Dolfost/pedals/README.md

# Foot pedal box

**English** · [Українська](README.uk.md)

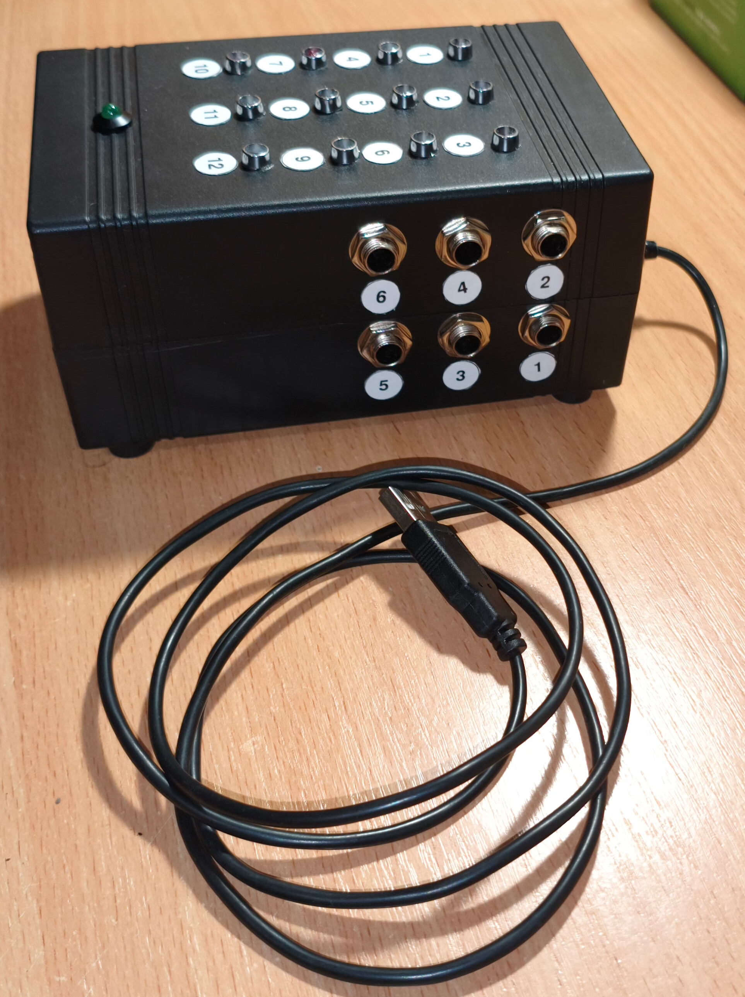
[picture p1: images/finish.jpg]
The finished box: twelve jacks, twelve LEDs, one USB cable


Twelve foot-pedal inputs for a PC, built around the controller board of a used Genius USB keyboard.
Each input is a 6.35 mm mono jack for a momentary tattoo pedal. 
Pressing a pedal lights that channel's LED and, through an optocoupler, presses one of F1-F12 on the keyboard matrix.
On the PC, keyd turns those keys into Ctrl+Alt+Shift+F1..F12 and REAPER scripts bound to them switch guitar amp tracks.
Whatever is left over is free for game binds.

## Story

The box exists to change guitar tones in REAPER without taking a hand off the guitar: one tone per pedal, up to twelve of them.
Ready-made USB foot switches (the PCsensor kind that the `footswitch` tool programs) offer one to three switches for real money: a triple one like the [FS323-P](https://prom.ua/ua/m-7539015935706131995-fs323-trojnaya-usb.html) is listed at 2,250 UAH on prom.ua, so twelve switches that way would be about 9,000.
Tattoo pedals are the opposite: sturdy metal momentary switches with a 6.35 mm mono plug on a stock cable, for a fraction of the price.
All they need is something to plug into.

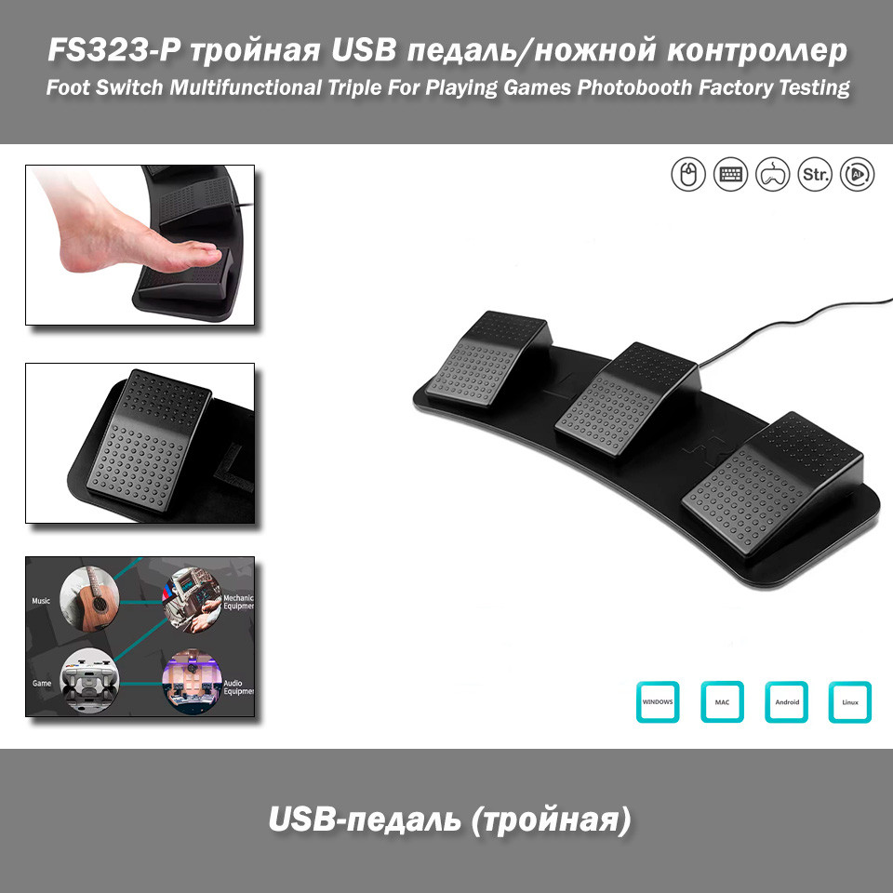
[picture p2: images/ready-made-fs323-p.jpg]
FS323-P: a ready-made triple USB foot pedal, 2,250 UAH


<p align="center">
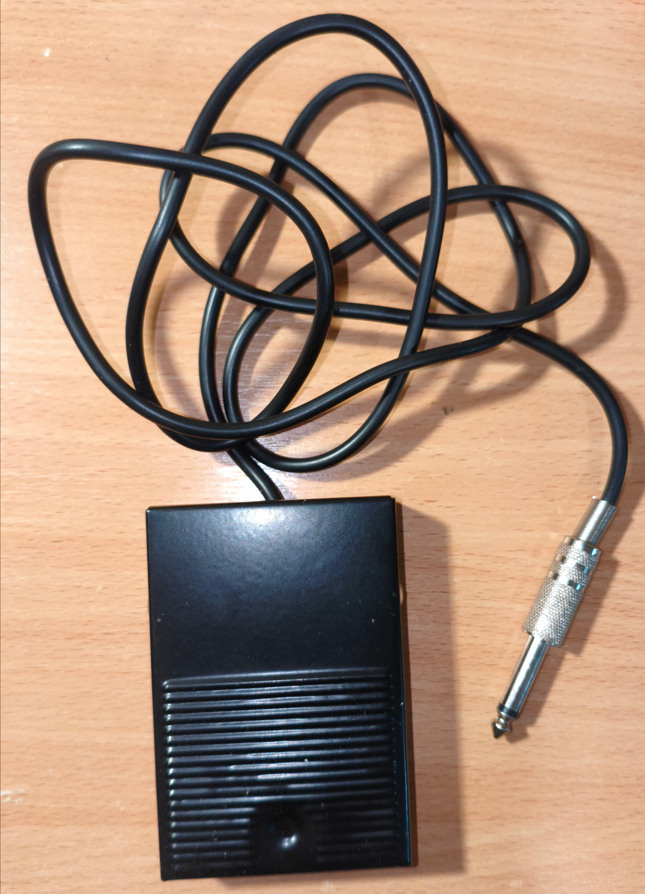
[picture p3: images/pedal_front.jpg]
A tattoo pedal: steel body, momentary switch, 6.35 mm mono plug on a stock cable

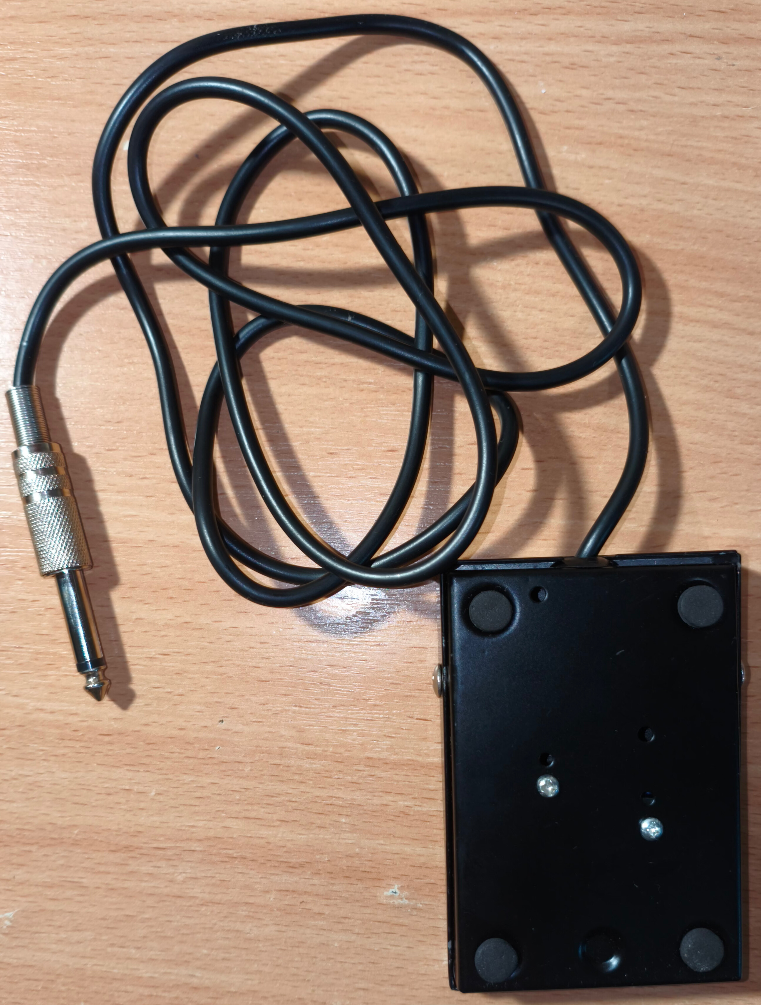
[picture p4: images/pedal_back.jpg]
The underside: four rubber feet and the switch screws

</p>

That something is the old Instructables recipe [A Foot Pedal for the Computer Keyboard](https://www.instructables.com/A-Foot-Pedal-for-the-Computer-Keyboard/): take a USB keyboard apart, keep the controller PCB, and close the matrix contacts of a key with a switch.
This build changes two things about it.

- **Nothing touches the matrix directly.** Each pedal closes a 5 V loop through a PC817 optocoupler, and the phototransistor presses the key.
The pedal cables are galvanically isolated from the controller, every channel gets a status LED in series for free, and since a phototransistor conducts one way only, pedals cannot ghost each other the way membrane contacts can.
- **The keys are F1-F12, and keyd rewrites them.** The box enumerates as an ordinary keyboard, so without a remap every pedal would collide with the real keyboard.
A per-device keyd config turns each F-key into a Ctrl+Alt+Shift chord that nothing else types.

The first case layout put all twelve jacks on one long side with the LEDs next to them.
The final one splits the jacks six per side, one row per case shell, and moves the LEDs to the top where they are visible from above.
The first case considered (Sanhe 11-4, 100 x 68 x 50 mm) turned out too small for twelve jacks; the D150B at 148 x 92 x 68 mm with removable end panels is what got built.

| When | What |
|---|---|
| 2026-10-11 | USB foot pedals considered; `footswitch` tooling added to the NixOS config |
| 2026-10-13 | parts list priced and ordered ([PARTS.md](PARTS.md)) |
| 2026-10-14 | matrix pins measured, schematic drawn, generator script written |
| 2026-10-16 .. 17 | donor keyboard stripped, controller connector extended onto perfboard |
| 2026-10-18 | opto board built and bench-tested against the controller; drill templates drawn in FreeCAD |
| 2026-10-23 | case drilled, everything assembled, labels on; keyd and REAPER configs committed to dotfiles |

## How it works

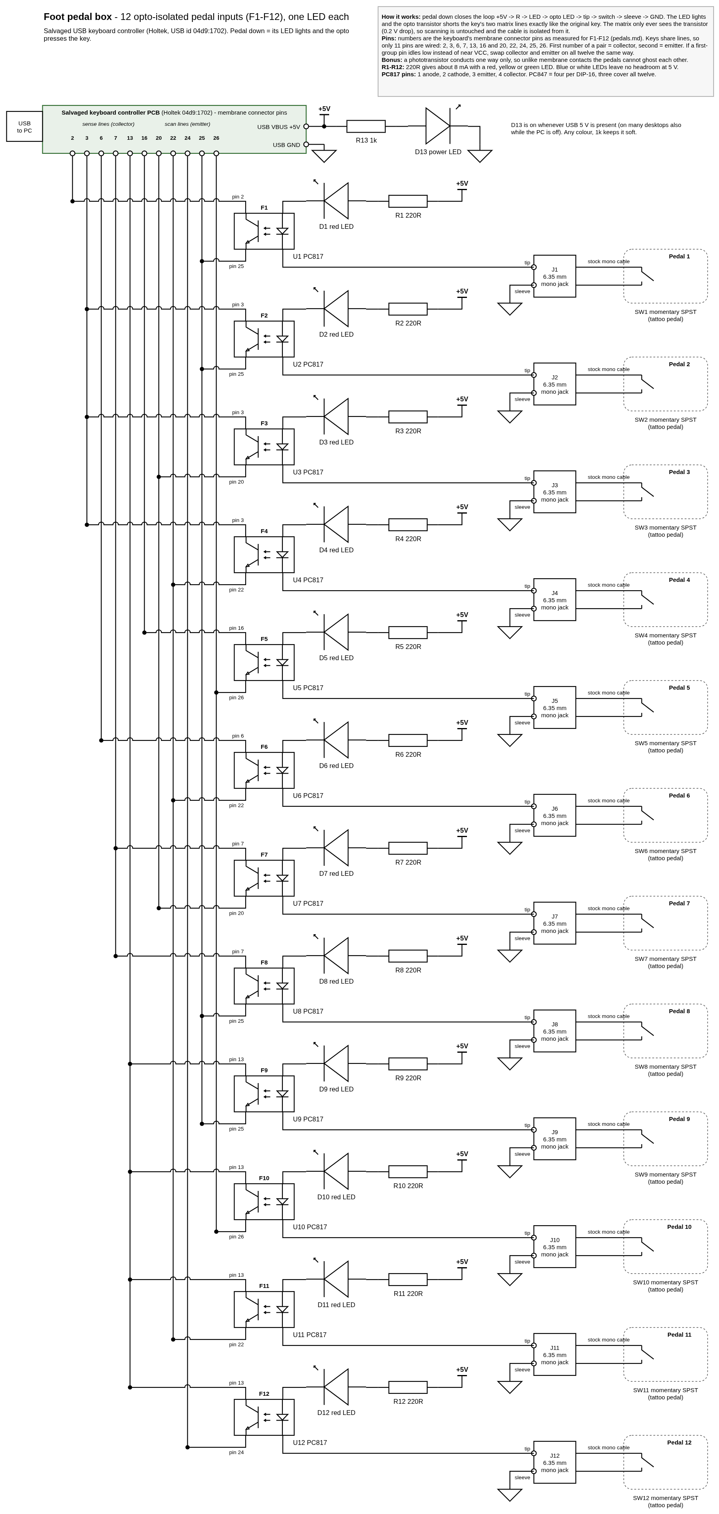
[picture p5: pedal-box-schematic.png]
Schematic


Editable source: [pedal-box-schematic.drawio](pedal-box-schematic.drawio).
The file is generated by [gen-schematic.pl](gen-schematic.pl), see [Regenerating](#regenerating).

Pedal down closes a 5 V loop: `+5V -> 220R -> LED -> PC817 input -> jack tip -> pedal switch -> jack sleeve -> GND`.
The LED lights, and the PC817 phototransistor shorts the key's two matrix lines exactly like the original key did.
The matrix only ever sees the transistor (about 0.2 V drop), so scanning is untouched, and the pedal cable is galvanically isolated from it.

Never put an LED in series with the matrix contact itself: its forward voltage eats the logic margin and the scan pulses are microamps anyway.

The power LED (D13) sits straight across USB 5 V through 1k and is on whenever the port is powered, which on many desktops includes soft-off.

### Measured connector pins

Pins of the keyboard's membrane connector that produce each key, measured by shorting pairs with a wire while watching `sudo keyd monitor`.

| Key | pin a (collector) | pin b (emitter) |
|-----|---|---|
| F1  | 2 | 25 |
| F2  | 3 | 25 |
| F3  | 3 | 20 |
| F4  | 3 | 22 |
| F5  | 16 | 26 |
| F6  | 6 | 22 |
| F7  | 7 | 20 |
| F8  | 7 | 25 |
| F9  | 13 | 25 |
| F10 | 13 | 26 |
| F11 | 13 | 22 |
| F12 | 13 | 24 |

Keys share lines, so only 11 pins are wired: 2, 3, 6, 7, 13, 16 (sense lines) and 20, 22, 24, 25, 26 (scan lines). 
Eleven wires run from the controller to the opto board, not 24.

### Circuit notes

- Sense vs scan: with the board powered, the pad of a pair that idles near VCC is the sense line (collector), the pulsed one is the scan line (emitter).
The table assumes the first number is sense.
If a sense pin idles low instead, swap collector and emitter on all twelve optos the same way.
Wrong polarity only means no key event, nothing breaks.
- Resistors: 220R gives about 8 mA through a red, yellow or green LED plus the opto input.
Blue or white LEDs leave no headroom at 5 V.
For the power LED alone, 330R is bright and 1k is dim with red, yellow or green.
- LED polarity: anode toward +5V (through the resistor), cathode toward the opto anode.
PC817 pins: 1 anode, 2 cathode, 3 emitter, 4 collector.
- Keep the controller PCB intact and its USB cable; tap VBUS and GND where the cable lands on the PCB.

## Build log

### Donor controller

<p>
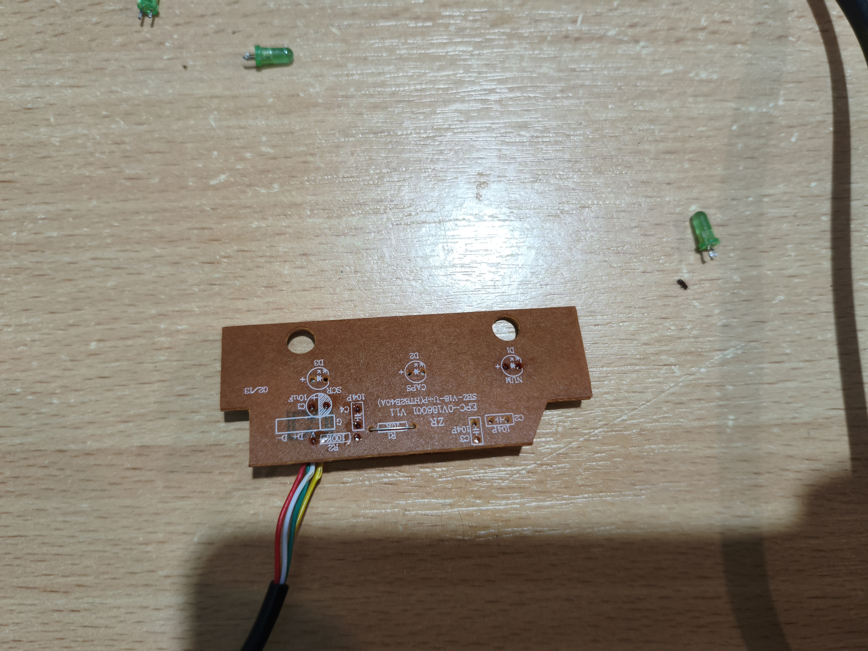
[picture p6: images/kb_board_front.jpg]
Controller PCB, component side

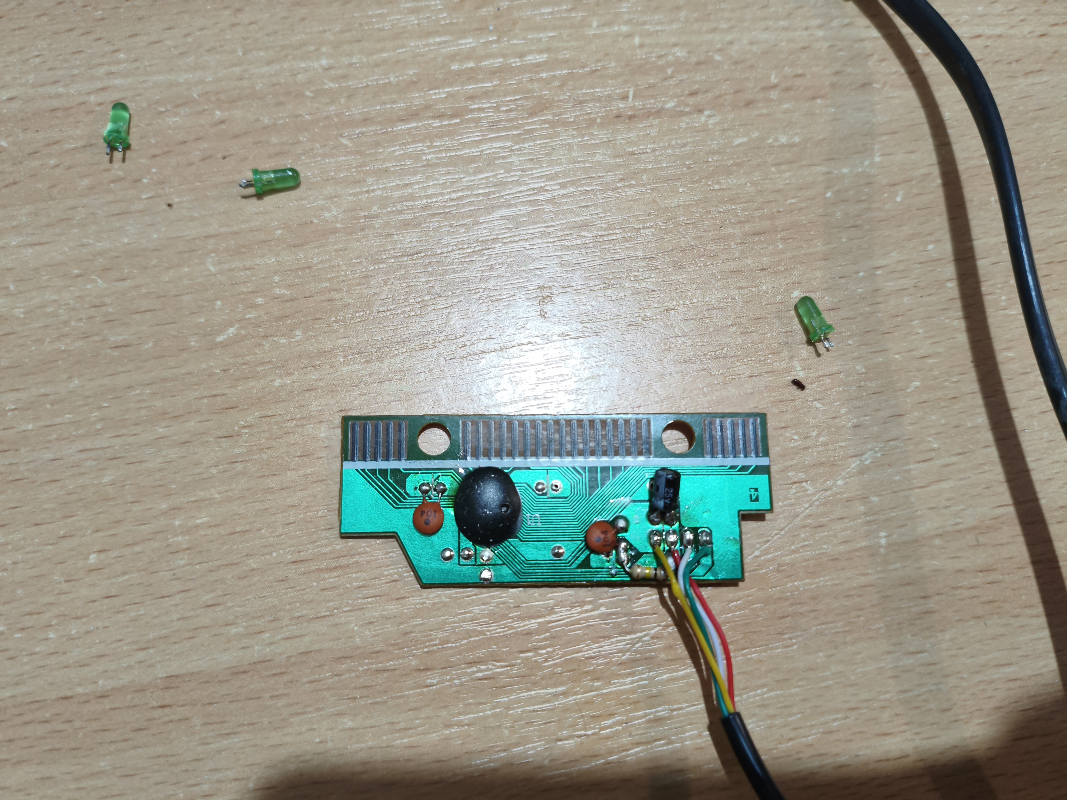
[picture p7: images/kb_board_back.jpg]
Controller PCB, contact side

</p>

The controller of a used Genius USB keyboard (Holtek, USB id 04d9:1702, PCB marked EPC-OV186001 V1.1): a chip-on-board blob, a handful of passives, the USB cable, and a row of 26 contact fingers along one edge where the membrane used to plug in. 
The three green LEDs next to it are the Num, Caps and Scroll indicators, desoldered.

### Extending the connector

<p>
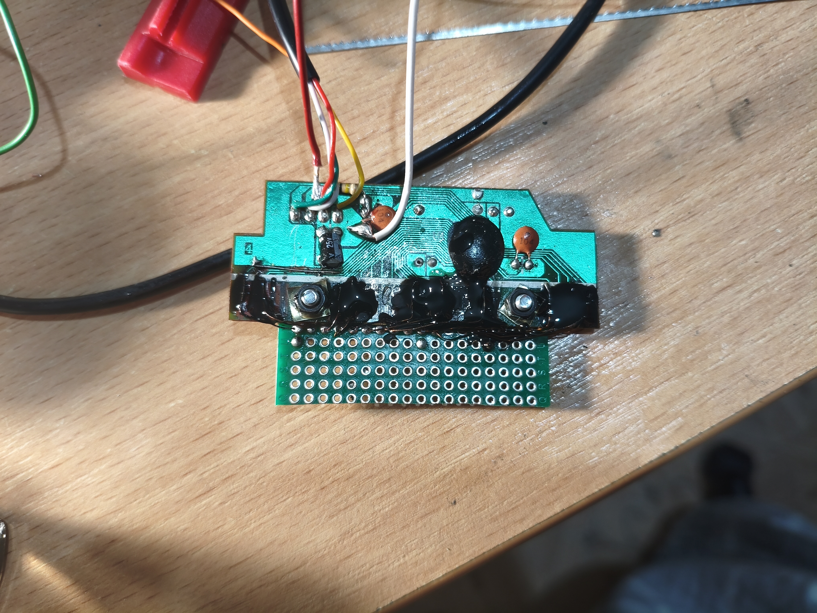
[picture p8: images/kb_board_extended_with_prototype_board.jpg]
Perfboard strip glued along the connector edge

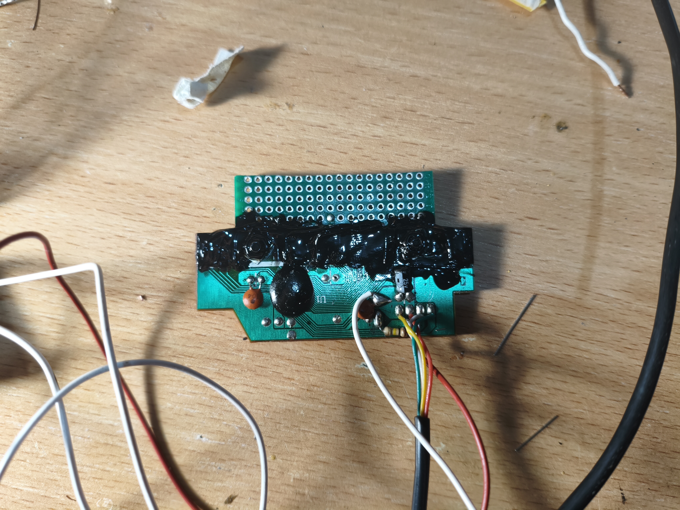
[picture p9: images/kb_board_extended_with_prototype_board_2.jpg]
The same from the other side

</p>

Membrane fingers cannot take hook-up wire, so a strip of perfboard was glued along the connector edge, each pad was run to a perfboard pad with thin enamel wire, and the joints were sealed under a coat of black nail polish.
The eleven matrix lines and USB power now come off the perfboard pads instead.

### Opto board

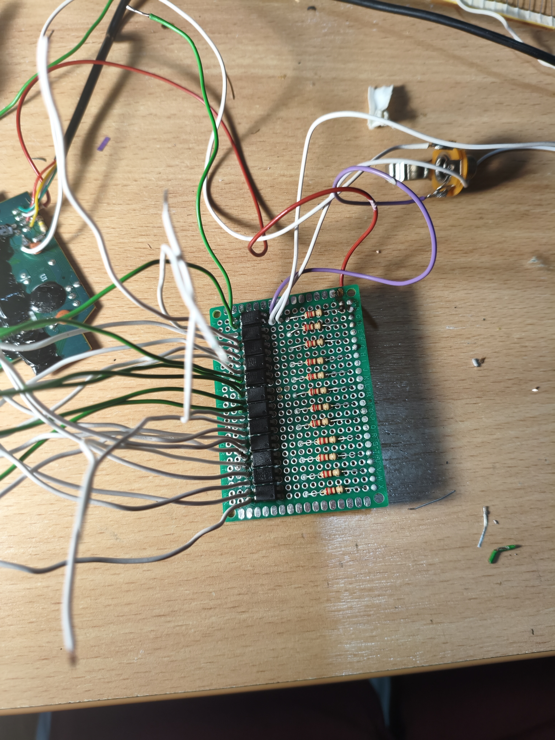
[picture p10: images/optotrons_on_pcb.jpg]
Twelve PC817 and twelve resistors on a 50 x 70 mm perfboard


Twelve PC817 in a column and twelve 220R resistors next to them on a 50 x 70 mm perfboard.
The green wires are the eleven matrix lines from the controller; the pedal, LED and ground wires go out the other side.
The jack in the corner is the first one wired up for testing.

### Bench test

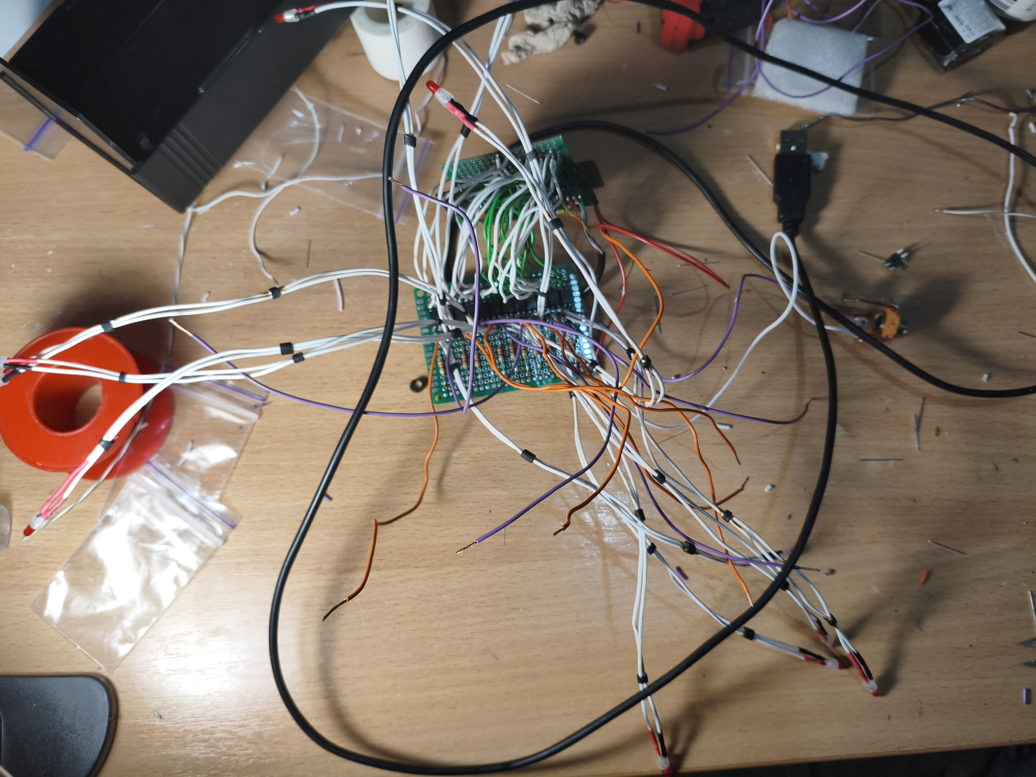
[picture p11: images/optotrons_paired_with_keyboard_board.jpg]
Controller and opto board wired together on the bench


Everything wired together on the bench before any hole was drilled: the controller, the opto board, twelve LEDs on heat-shrunk leads, one jack and the USB cable, and each channel checked before going further.

### Case design

The case is drawn in FreeCAD ([connectors.FCStd](connectors.FCStd)): one sketch per panel of the D150B, plus two TechDraw pages that were printed at 1:1 and used as drill templates. 
The sketches, as drawn (dashed lines are construction geometry):

| | |
|---|---|
| top | side |
| bottom | front |
| back | first side layout |
| label study | |

Where things go:

- **Side panels** (left and right): six jacks each in two rows of three at 21 mm pitch.
The rows sit 13 mm above and 6.5 mm below the seam, so each row is in its own case shell and the shells still come apart.
All jacks are on one half of the panel; the boards live in the other half.
- **Top**: twelve LED holders on a 3 x 4 grid at 20 x 25 mm between the case's decorative grooves, and the power LED off to one side.
- **Bottom**: four M3 holes on a 45 x 65 mm pattern for the opto board, with nuts stacked as spacers.
- **Front end panel**: two M3 holes 39.5 mm apart, matching the two mounting holes the controller PCB already had.
- **Back end panel**: one 12.5 mm hole for the PG7 gland the USB cable passes through.

The TechDraw pages, [lrt.pdf](lrt.pdf) (left, right, top) and
[fbb.pdf](fbb.pdf) (front, back, bottom):

<p>
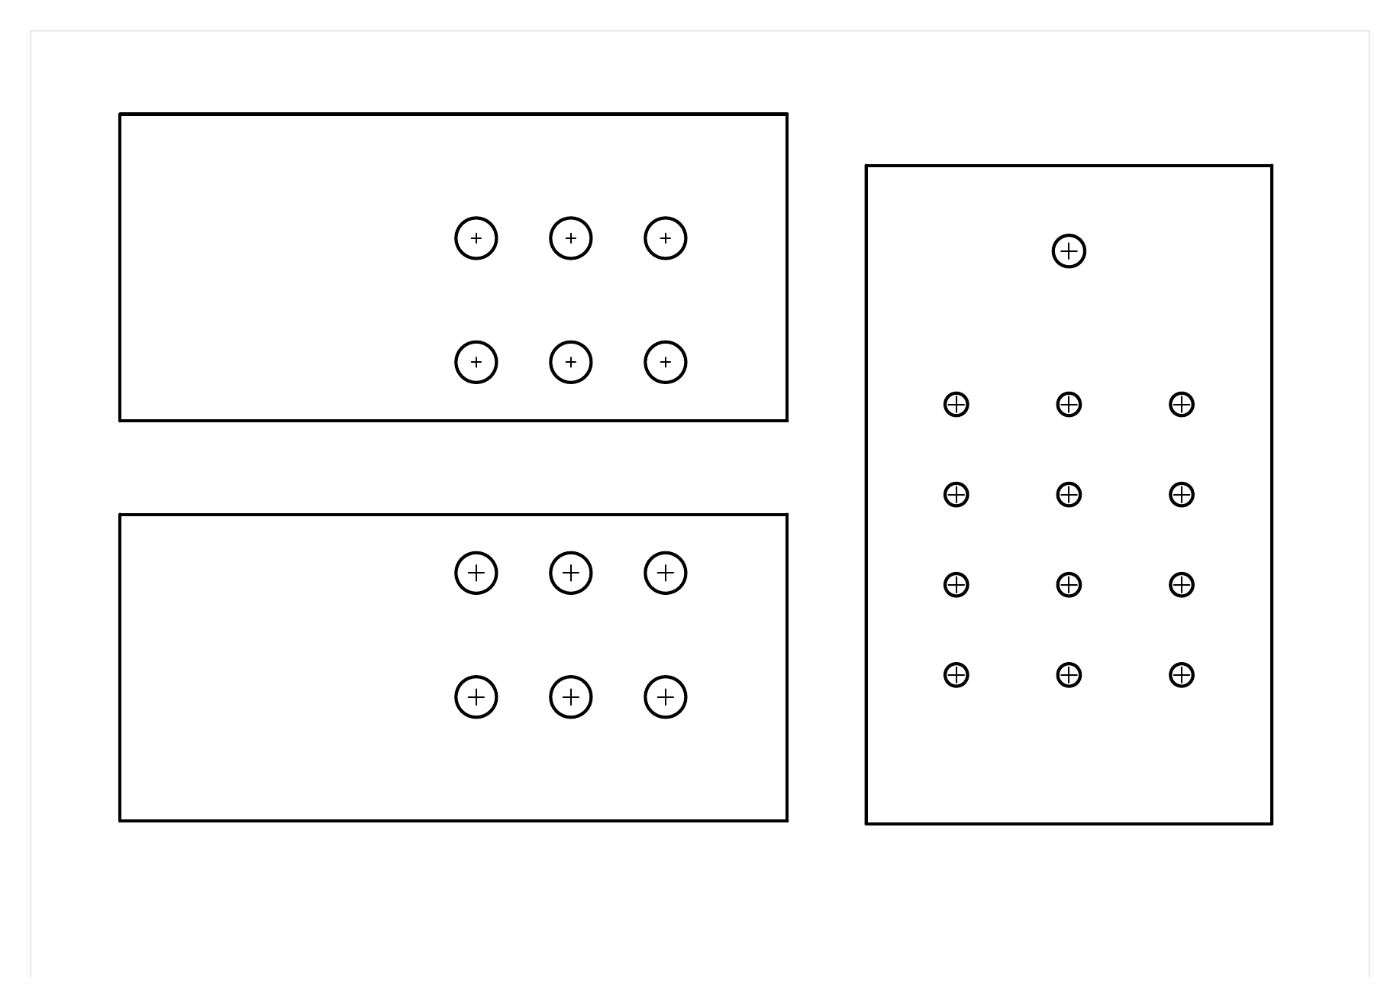
[picture p12: images/sketches/lrt.png]
Drill template: left, right and top panels

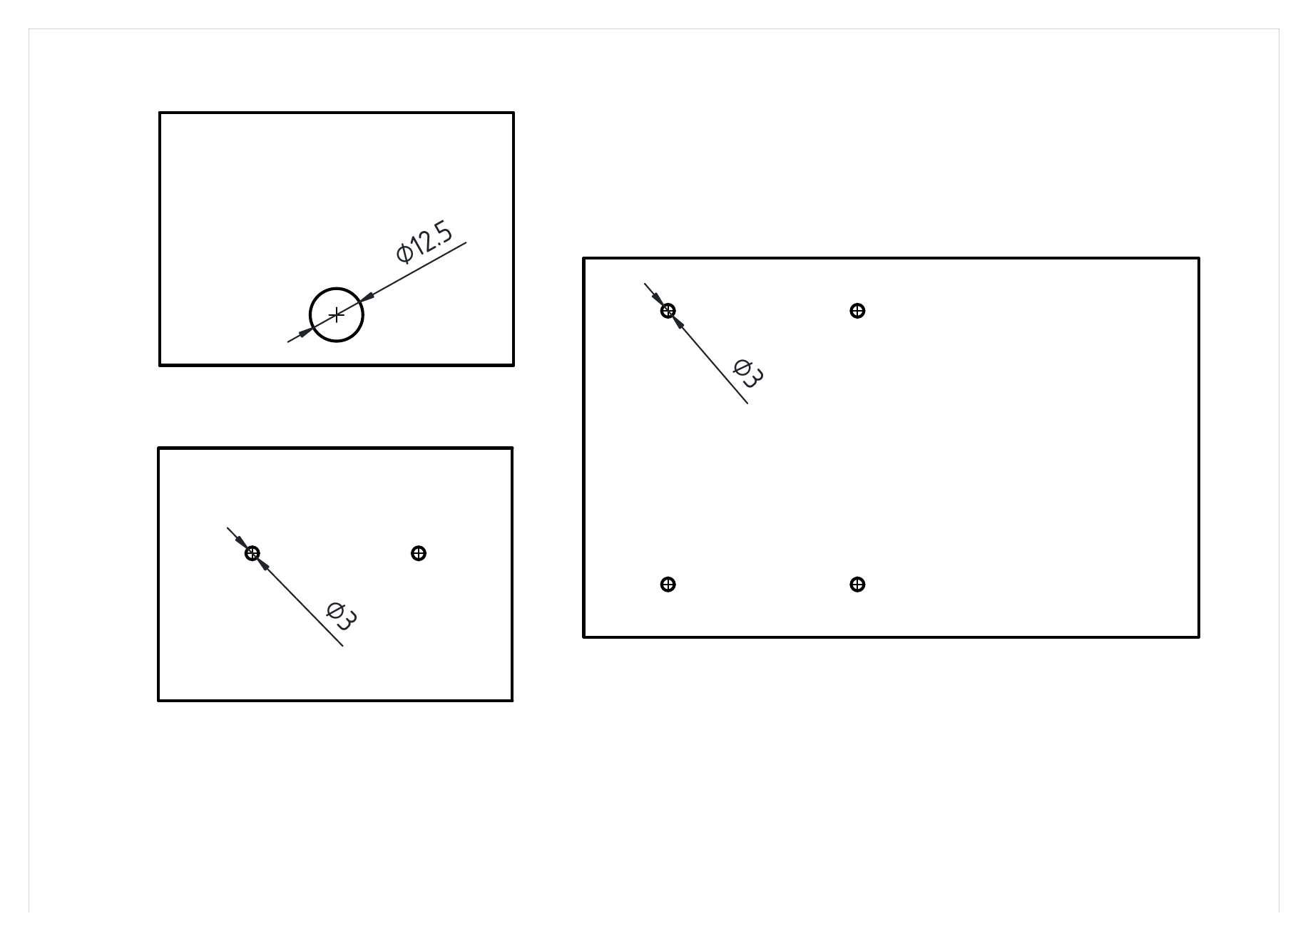
[picture p13: images/sketches/fbb.png]
Drill template: front, back and bottom panels

</p>

Drill sizes used, and what the parts actually measure:

| Part | Hole drawn | Part measured |
|---|---|---|
| 6.35 mm jack GT1-2025 | 9 mm | 8 mm bush, 14 mm nut |
| 3 mm LED holder PLH-3 | 5 mm | 5.5 mm body, 8 mm bezel |
| power LED holder | 7 mm | 8 mm body, 9 mm bezel |
| PG7 gland | 12.5 mm | |
| M3 screws | 3 mm | |

### Drilling

<p>
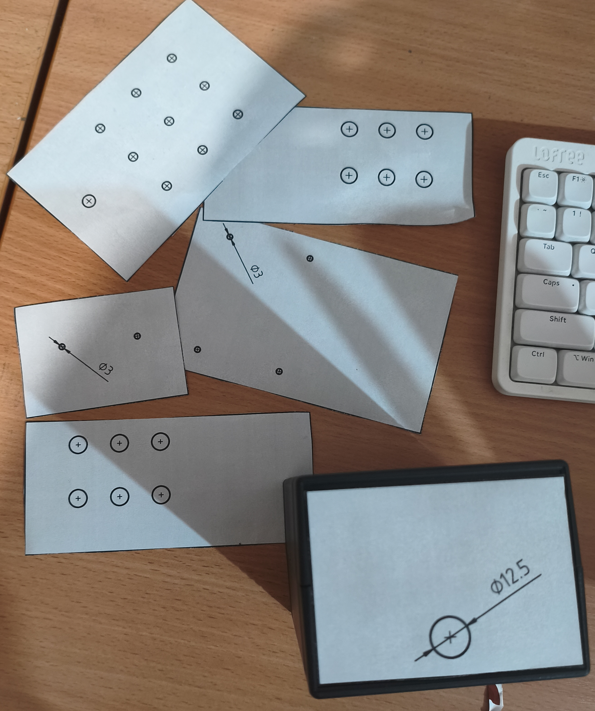
[picture p14: images/hole_templates.jpg]
Printed templates cut out and laid on the panels

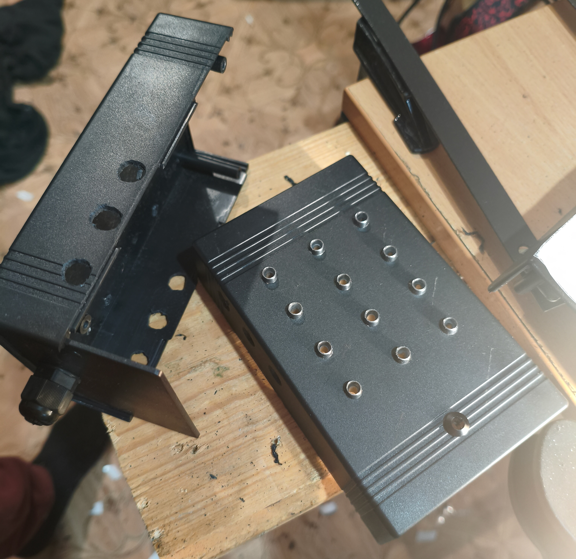
[picture p15: images/case_cut_process.jpg]
Top and side panels drilled, gland fitted

</p>

The pages were printed at 100 %, cut out, taped to the panels, and the holes drilled straight through the paper.
The large holes for the jacks, the power LED and the gland were drilled undersize and reamed out to size with scissors.
The gland went into its end panel first.

### Assembly

<p>
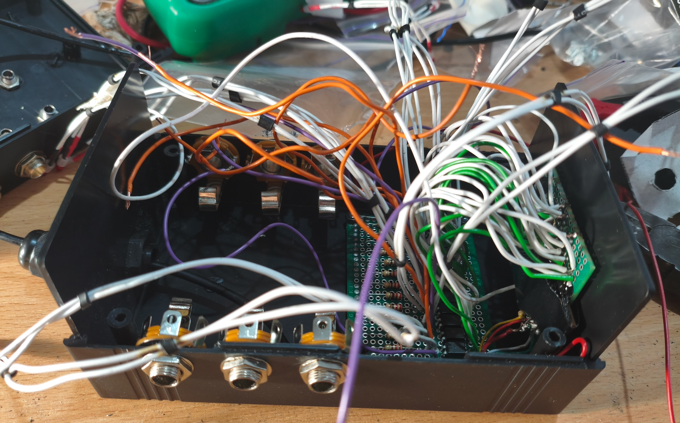
[picture p16: images/case_compontents_inside.jpg]
Jacks mounted, boards going in

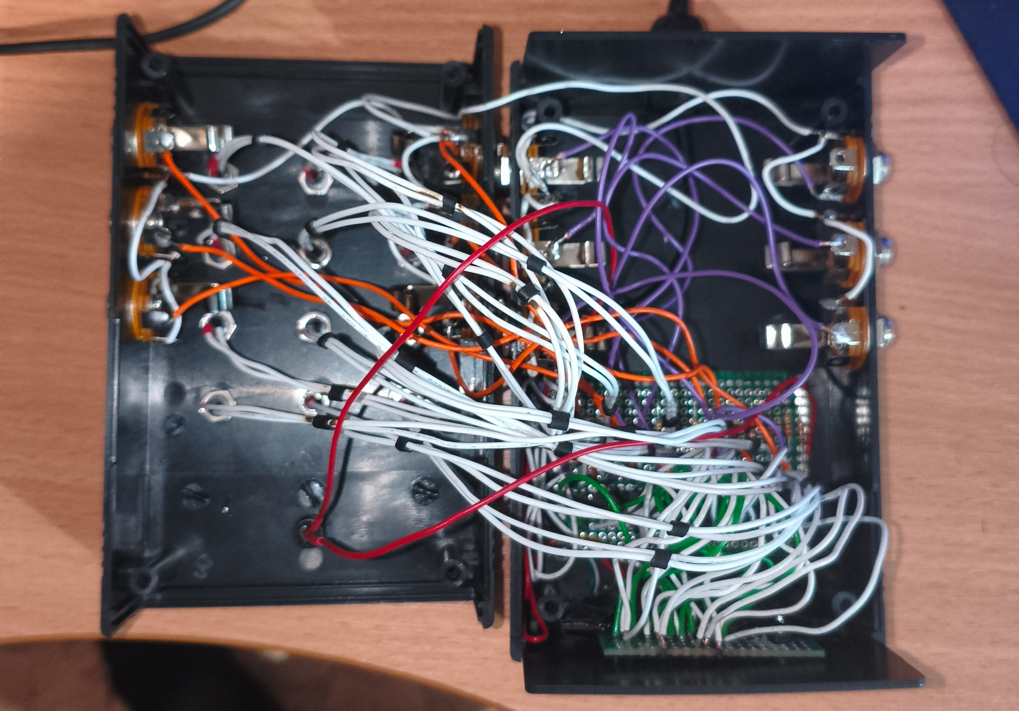
[picture p17: images/case_compontents_inside_leds_in.jpg]
Both shells open, LEDs in their holders

</p>
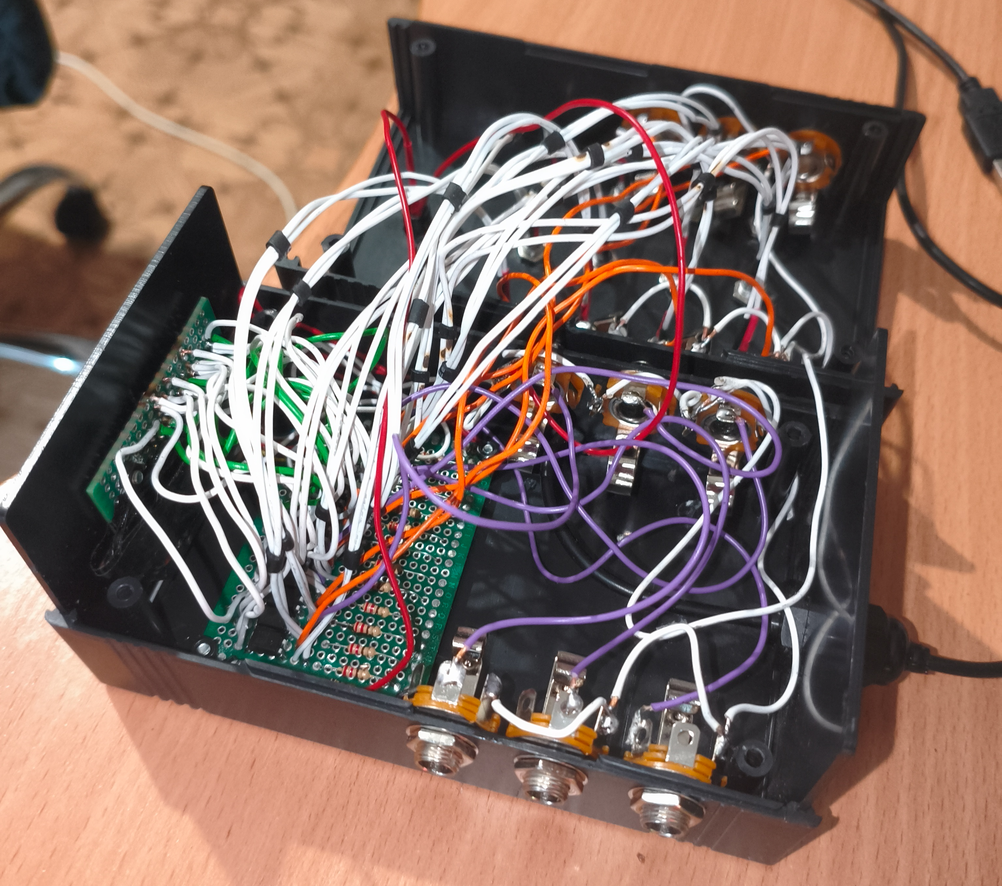
[picture p18: images/case_compontents_inside_leds_in_other_angle.jpg]
Controller on the end panel, opto board on the bottom


Jacks in both shells, the controller with its perfboard extension screwed to the front end panel, the opto board on the bottom, LEDs in their holders in the top shell.
Wire ends at the jacks and LEDs are heat-shrunk.

### Labels

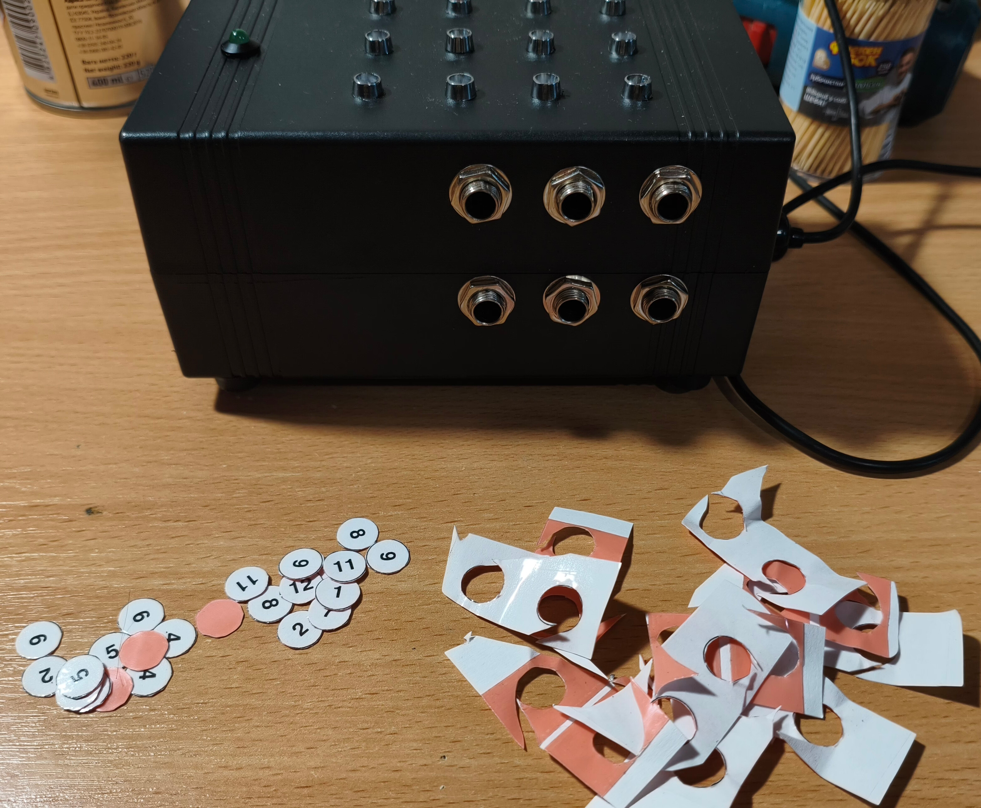
[picture p19: images/case_labels.jpg]
The closed box and a pile of cut-out number labels


[labels-1-12.pdf](labels-1-12.pdf) is a sheet of two sets of numbered discs (print at 100 %, no page scaling; there is a 50 mm reference bar).
Printed on plain paper, laminated with Scotch tape on the front and double-sided tape on the back, then cut out:

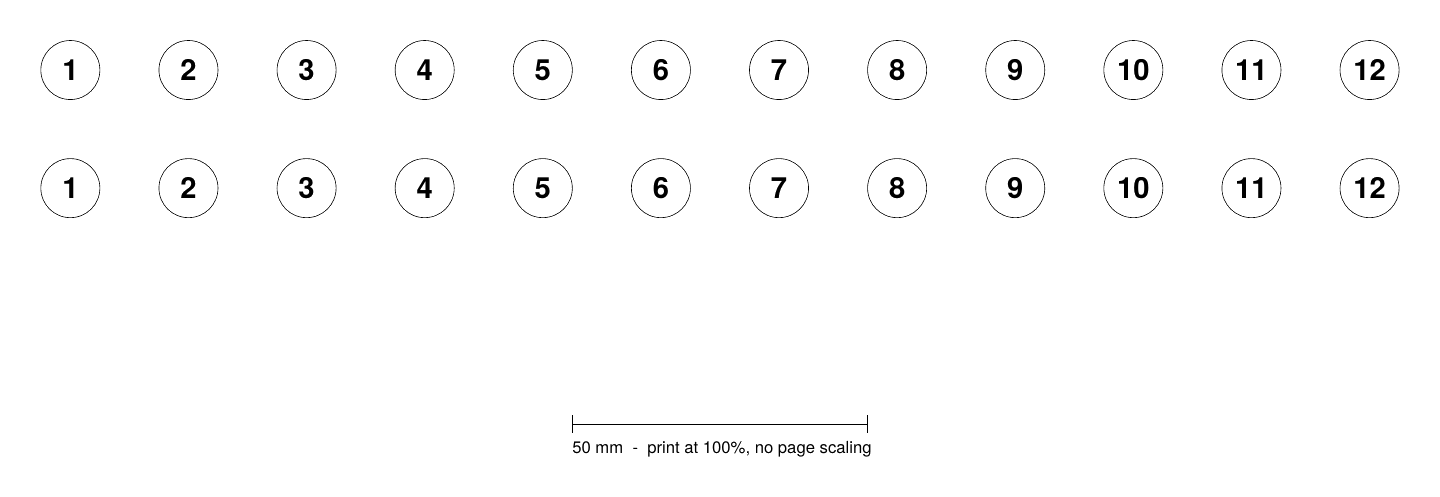
[picture p20: images/sketches/labels-1-12.png]
The label sheet


### Result

<p align="center">
Finished box
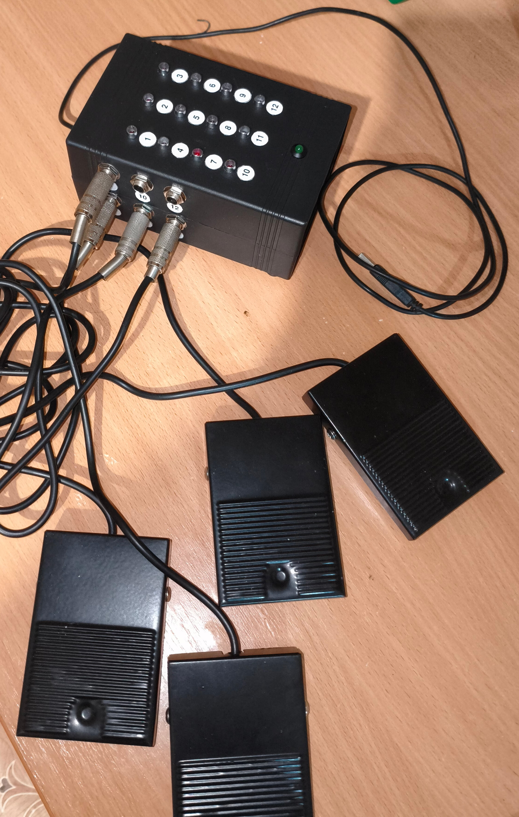
[picture p21: images/finish_with_cables.jpg]
The box with four pedals plugged in

</p>

Jacks 1-6 on one side, 7-12 on the other, LED for each on top, a green power LED in the corner, one USB cable out the back.
Four pedals so far; the other eight jacks wait for more.

## Software

### keyd

The box enumerates as the original keyboard (Holtek, USB id 04d9:1702).
On NixOS, `nix/modules/system/pedal/default.nix` in the dotfiles gives it its own keyd config, which is what the host actually runs:

```nix
services.keyd.keyboards.pedal = {
  ids = [ "04d9:1702" ];
  settings = {
    # A held macro key starts repeating after this; at ~25 days it never does.
    global.macro_timeout = 2147483647;
    main = {
      f1 = "macro(C-A-S-f1)";
      f2 = "macro(C-A-S-f2)";
      # ...
      f12 = "macro(C-A-S-f12)";
    };
  };
};
```

[keyd/pedal.conf](keyd/pedal.conf) is the same thing as a plain keyd file for a non-Nix machine.
An explicit id beats the `*` default config, so the board gets only this file.
Two things are going on in it:

- **A macro instead of a remap.** The controller holds the key down for as long as the foot is on the pedal, and the compositor turns that into auto-repeat, so a REAPER action bound to a plain key would fire over and over.
`macro(...)` presses and releases the chord once when the pedal goes down and does nothing more until it comes up; the huge `macro_timeout` stops the macro itself from repeating.
- **Ctrl+Alt+Shift+F1..F12, not F13..F24.** F13-F24 look like the obvious free keys, but they do not survive the trip: the default xkb map turns FK13..FK23 into XF86Tools/Launch/Touchpad keysyms, and REAPER's SWELL only translates F1..F12 to begin with.
A three-modifier chord collides with nothing a keyboard types, and Shift keeps Ctrl+Alt+Fn from being read as a VT switch.

The same module installs `footswitch`, the programmer for PCsensor-style USB pedals, which this box does not need.

### REAPER

`reaper/Scripts/amp-switch/` in the dotfiles holds `amp_1.lua` through `amp_12.lua` and `amp_cycle.lua`.
A copy is kept here under [reaper/amp-switch/](reaper/amp-switch/) for the record; REAPER loads the ones in the dotfiles.
Each `amp_N.lua` arms exactly the N-th track whose name starts with `GT_` (record arm plus input monitoring) and unarms the other `GT_` tracks, so one pedal is one amp chain.
`amp_cycle.lua` alternates between two of them from a single pedal.
The home-manager guitar module links the directory into REAPER's resource path so the scripts show up under ReaScript: Load; the key bindings themselves are assigned once per machine in the Actions list, because REAPER rewrites `reaper-kb.ini` on exit and keeping it in the repo would fight it.

### Probing notes

Learned while finding the matrix pins:

- keyd classifies a device as a keyboard only if it has the letter keys or a media key.
The board's "System Control" USB interface (power, sleep, wake) has neither, so keyd ignores it and logind reads it directly.
Shorting the wrong trace can shut the PC down.
For a probing session hold an inhibitor first:
  `systemd-inhibit --what=handle-power-key:handle-suspend-key:handle-hibernate-key:handle-reboot-key --who=pedal sleep 7200`
- `keyd monitor` cannot see devices the daemon has grabbed; it shows the virtual keyboard's output instead, which is fine for finding keys.

## Parts

Prices in UAH as listed by the shops on 2026-10-13.
"Bought" includes shop minimum orders; "Used" is what is in the box.

| Part | Bought | Used | Each | Total  |
|---|---:|---:|---:|---:|
| Genius USB keyboard, Holtek controller, USB id 04d9:1702 | | 1 | already had | 0.00 |
| [PC817C optocoupler, DIP-4](https://www.rcscomponents.kiev.ua/product/pc817c-optron_211557.html) | 15 | 12 | 2.60 | 39.00  |
| [220 ohm 0.25 W](https://www.rcscomponents.kiev.ua/product/220-ohm-5-0-25w-vyv-cf1-4w-220r_92206.html) | 30 (min) | 12 | 0.40 | 12.00  |
| [1 kohm 0.25 W](https://www.rcscomponents.kiev.ua/product/1-kohm-5-0-25w-vyviv-cf1-4w-1k_13760.html) | 30 (min) | 1 | 0.40 | 12.00  |
| [3 mm red LED, Kingbright L-934ID](https://www.rcscomponents.kiev.ua/product/svitlodiod-3mm-chervonyi-625nm-60-l-934id-kingbright_46859.html) | 15 | 12 | 3.60 | 54.00  |
| [3 mm LED panel holder PLH-3](https://www.rcscomponents.kiev.ua/product/trymach-svitlodioda-3mm-plh-3_207284.html) | 15 | 12 | 0.90 | 13.50  |
| green LED with holder (power) | | 1 | not in the order | |
| [Perfboard 50 x 70 mm, double-sided](https://www.rcscomponents.kiev.ua/product/maketna-plata-5x7-dvostoronnia-zelena_144388.html) | 2 | 1 + a strip | 12.90 | 25.80  |
| [6.35 mm mono panel jack GT1-2025](https://www.rcscomponents.kiev.ua/product/hnizdo-mono-6-35-mm-na-panel-gt1-2025_179607.html) | 13 | 12 | 8.00 | 104.00 |
| [Case D150B, 148 x 92 x 68 mm, ABS](https://www.rcscomponents.kiev.ua/product/korpus-d150b-68kh92kh148mm_192382.html) | 1 | 1 | 64.60 | 64.60  |
| [PG7 cable gland](https://www.rcscomponents.kiev.ua/product/pg7-b-kabelnyi-vvid-neilon-neoprenovyi-ushchilniuvach_133376.html) | 1 | 1 | 5.40 | 5.40 |
| [PG7 locknut](https://www.rcscomponents.kiev.ua/product/kontrhaika-pg7-poliamid_128521.html) | 4 (min)  | 1 | 6.00 | 24.00  |
| [M3 x 8 screws](https://www.rcscomponents.kiev.ua/product/hvynt-m3x8-holovka-potaina-khrest-b3x8-bn388-philips_42387.html) | 30 (min) | 6 | 0.65 | 19.50  |
| [M3 nuts](https://www.rcscomponents.kiev.ua/product/haika-m3_189940.html) | 30 | ~12 | 0.16 | 4.80 |
| [Self-adhesive feet, 13 mm](https://www.rcscomponents.kiev.ua/product/nizhka-samokleina-d13mm-chorna-rf-005_171301.html) | 7 (min)  | 4 | 3.00 | 21.00  |
| [Tattoo pedal, metal, momentary, 6.35 mm mono plug](https://vsb-store.com.ua/000334-pedal-dlya-tatu-mashinki-zalizna-chorna) | 4 | 4 | 175.75 | 703.00 |

Totals, as bought:

| | UAH |
|---|---:|
| **The box** (electronics, jacks,  case, hardware) | **399.60**  |
| Four tattoo pedals | 703.00 |
| **Box and four pedals** | **1102.60** |
| Each further pedal | 175.75 |
| For comparison: one ready-made FS323-P with three switches | 2250.00 |

Wire, enamel wire and heat shrink came free from the parts bin.
Roughly 100 UAH of the box figure is minimum-order surplus (spare resistors, screws, locknuts, a jack and a perfboard); the parts actually inside the box come to about 300 UAH.
The whole thing with four pedals costs half of one three-switch FS323-P.

## Files

| File | What |
|---|---|
| `pedal-box-schematic.drawio` | editable schematic, draw.io |
| `pedal-box-schematic.png` | rendered schematic |
| `gen-schematic.pl` | generates the .drawio (coordinates, pins, bus) |
| `keyd/pedal.conf` | per-device keyd mapping, plain-file version of the NixOS module |
| `reaper/amp-switch/` | copy of the REAPER pedal scripts, for the record |
| `README.uk.md` | this document in Ukrainian |
| `PARTS.md` | parts list with shop links and prices |
| `connectors.FCStd` | FreeCAD: one sketch per case panel, two TechDraw template pages |
| `lrt.pdf`, `fbb.pdf` | the template pages, print at 1:1 |
| `labels-1-12.pdf` | numbered label discs, print at 100 % |
| `images/` | build photos |
| `gen-sketches.py` | writes the FreeCAD sketches to `images/sketches/*.svg` |
| `images/sketches/` | the sketches as SVG and the PDFs rendered to PNG, for this README |

## Regenerating

The schematic, after editing the generator:

```sh
perl gen-schematic.pl > pedal-box-schematic.drawio
drawio --export --format png --scale 1.5 --border 10 --output pedal-box-schematic.png pedal-box-schematic.drawio
```

Edits made by hand in draw.io are lost on regeneration, so either edit the
generator or stop regenerating once the hand edits start.

The sketch SVGs, after editing the FreeCAD file (headless, no GUI needed):

```sh
FC_OUT=images/sketches freecadcmd gen-sketches.py
```

The PNGs next to them are `pdftoppm -r 150` renders of the three PDFs.
