Dolfost/pedals/fbb.pdf

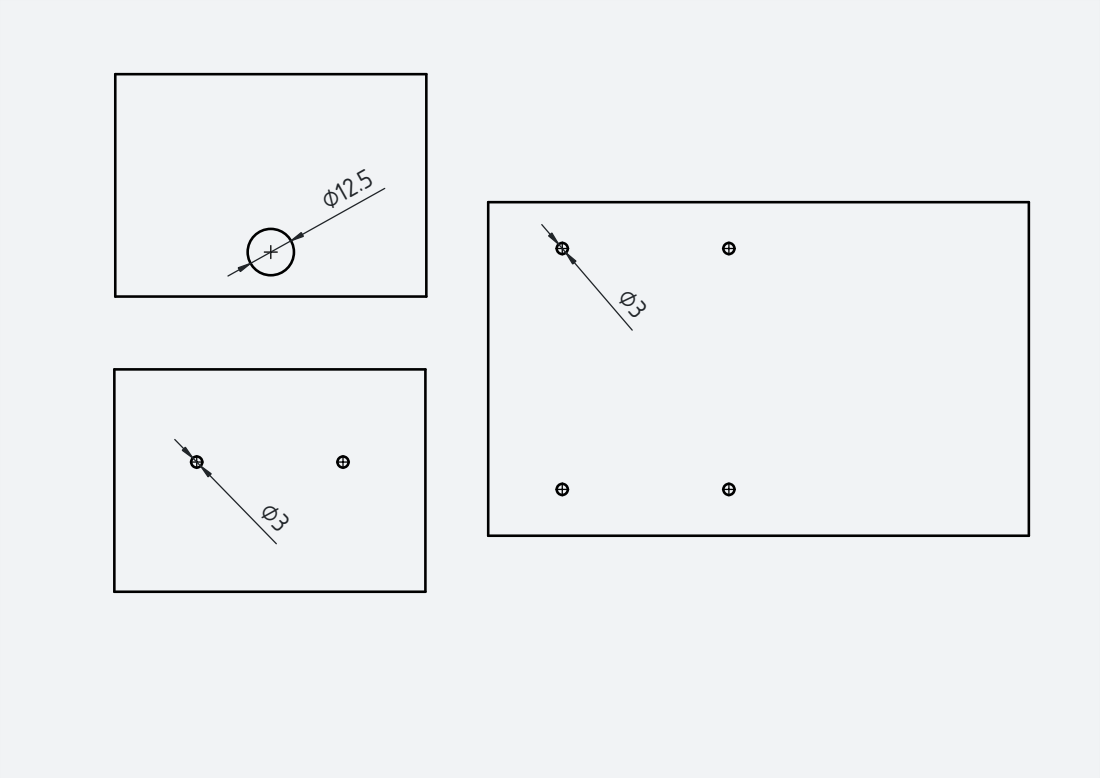
[picture p22: page 1]
