Dolfost/pedals/lrt.pdf

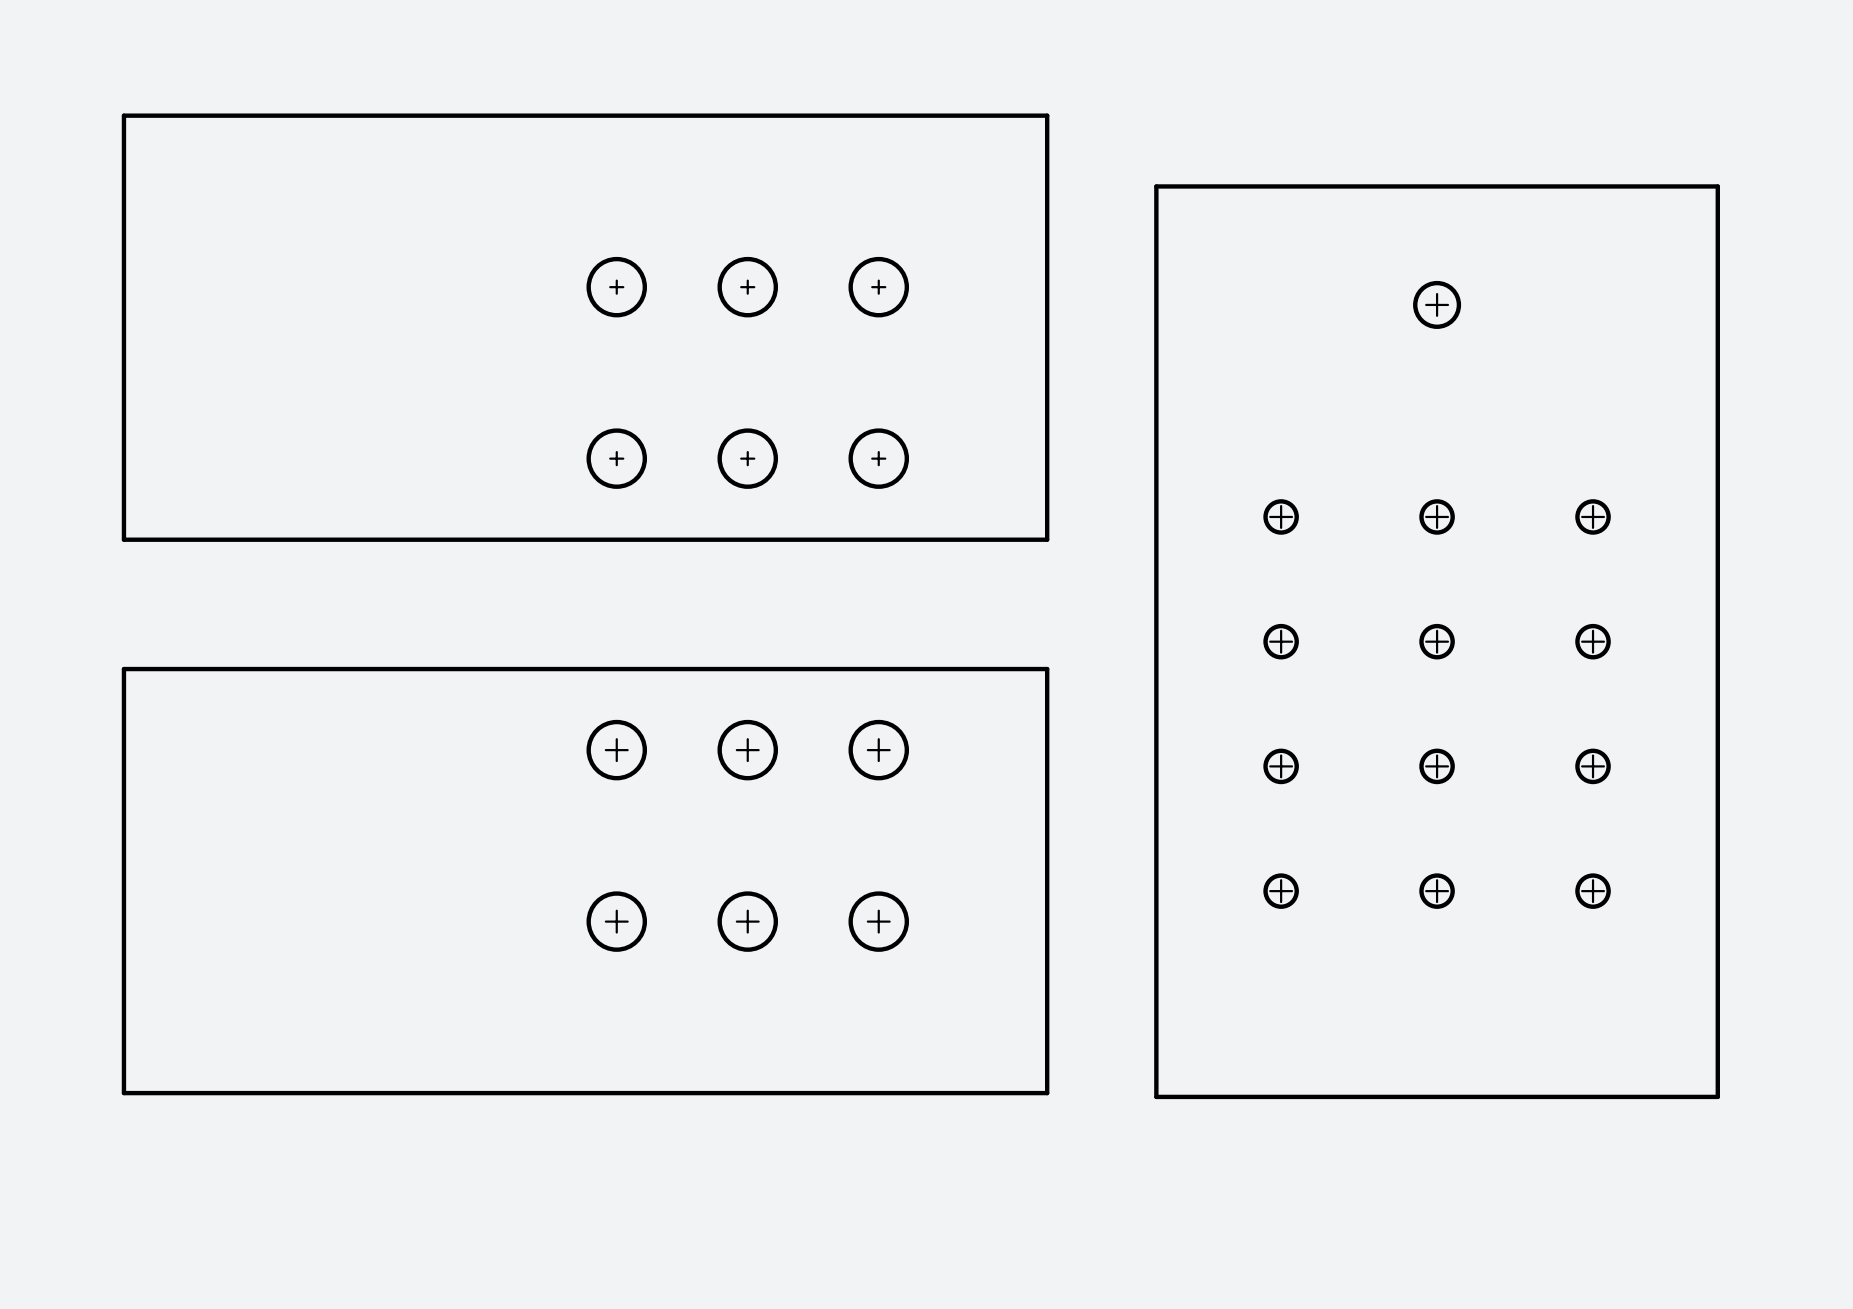
[picture p23: page 1]
