Dolfost/pedals/(list of files, cad)

Other CAD files:
connectors.FCStd
